Frueber/MidiTapTempoPedal/Schematics/9V DC Power Circuit/9V DC Power Circuit.jpg

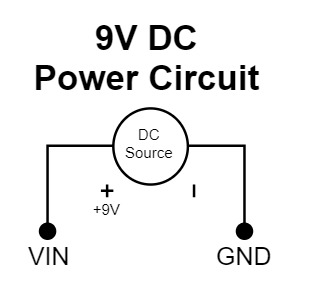
Schematics/9V DC Power Circuit/9V DC Power Circuit.jpg
