Frueber/MidiTapTempoPedal/Schematics/MIDI In Circuit/MIDI In Circuit.jpg

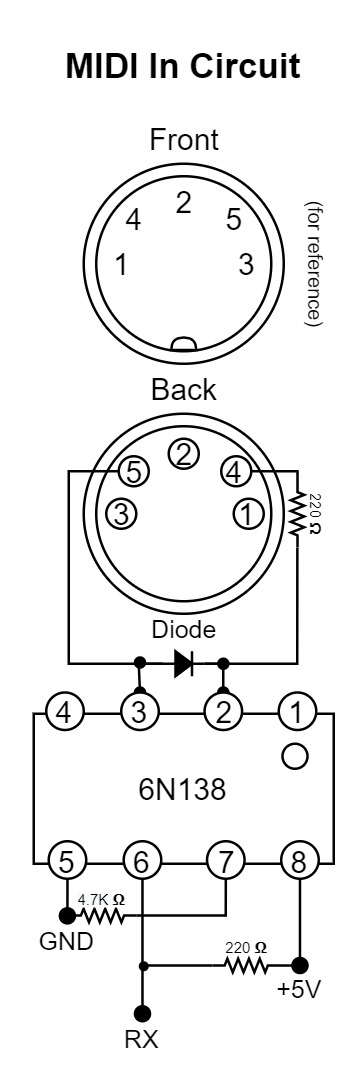
Schematics/MIDI In Circuit/MIDI In Circuit.jpg
