Frueber/MidiTapTempoPedal/Schematics/MIDI Out Circuit/MIDI Out Circuit.jpg

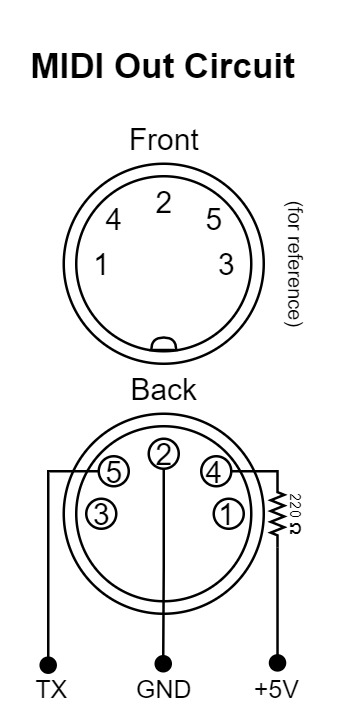
Schematics/MIDI Out Circuit/MIDI Out Circuit.jpg
