Frueber/MidiTapTempoPedal/Schematics/Momentary Button - SPST Foot Switch Circuit/Momentary Button - SPST Foot Switch Circuit.jpg

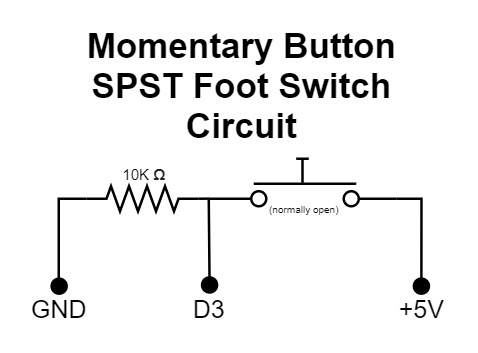
Schematics/Momentary Button - SPST Foot Switch Circuit/Momentary Button - SPST Foot Switch Circuit.jpg
