Frueber/MidiTapTempoPedal/Schematics/SPDT Switch Circuit/SPDT Switch Circuit.jpg

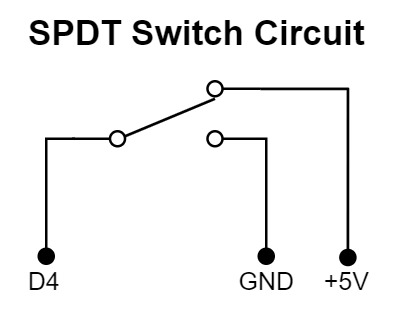
Schematics/SPDT Switch Circuit/SPDT Switch Circuit.jpg
