Frueber/MidiTapTempoPedal/Schematics/TS Jack Circuit/TS Jack Circuit.jpg

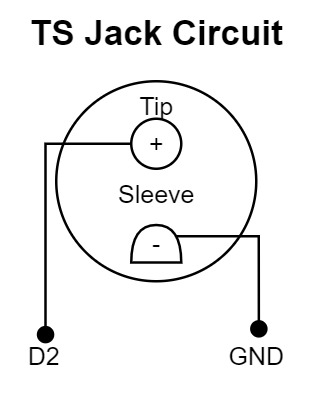
Schematics/TS Jack Circuit/TS Jack Circuit.jpg
