Frueber/MidiTapTempoPedal/(commit log)

2020-11-20 Adding the initial Arduino code. Updating the ReadMe.
2020-11-20 Updating documentation. Adding the ability to switch between a normally closed and normally open tempo signal.
2020-11-21 Updating to only use one pin for NC/NO as there are only two states. Added this to the hardware documentation. Also adding in the alias TOMATO per a conversation on PEEPO with Connor Smith.
2020-11-21 Adding 10k ohm resistor for the button in the hardware section of the documentation. Updating the button press and MIDI trigger code.
2020-11-22 Replacing a debugging delay call with a millisecond timeout for simulated tempo taps.
2020-11-22 Allowing a MIDI write with a button press to be in sync.
2020-11-27 Adding PCB files and diagrams.
2020-11-29 Adding MIDI In and Out schematic diagrams.
2020-11-29 Correcting ground connection for PCB. Adding more schematic diagrams.
2020-11-29 Updating circuit links on ReamMe for board.
2020-11-29 The added ground connection on the PCB was actual a duplication. Removing this.
